AIALRA-0/Viterbi_Decoder/DECISIONS.md

# DECISIONS

# Decision D-001: Use K=7 [171,133] as default formal target

## Context
K=7 [171,133] is a classic convolutional-code configuration with 64 states, which is large enough to expose meaningful VLSI architecture pressure.

## Options
K=3 toy design, K=5 medium design, K=7 formal design.

## Decision
Use K=7 [171,133] as the formal target, and optionally use K=3 only for debug smoke tests.

## Reason
K=7 has enough complexity for the open-ended course project; K=3 is kept only as a teaching and debug smoke-test configuration.

## Consequence
RTL and traceback complexity increase, so automated verification must be stricter.

# Decision D-002: Keep local machine configuration out of git

## Context
`config/local.env` contains absolute local paths for Vivado, Vitis, the FIR reference repository, and private board documents.

## Options
Commit `config/local.env`, commit only a safe template, or leave configuration undocumented.

## Decision
Keep `config/local.env` ignored by git and commit only `config/env.example`.

## Reason
The project must be reproducible without exposing private local paths or board document locations.

## Consequence
Every machine must create its own `config/local.env` from `config/env.example` before running local or board tools.

# Decision D-003: Do not enable board execution or flash programming in M0

## Context
The master prompt requires JTAG and UART board validation later, but default policy forbids flash writes unless explicitly authorized.

## Options
Enable board execution immediately, keep board execution disabled until M7, or skip board planning.

## Decision
Set `ALLOW_BOARD_RUN=0` and `ALLOW_FLASH_WRITE=0` in `config/local.env`.

## Reason
M0 only verifies paths and tool setup. Real board execution belongs to M7 and flash programming is not authorized.

## Consequence
M7 must explicitly record any board run command and must still avoid flash writes.

# Decision D-004: Use full-sequence Python Viterbi as the M1 golden model

## Context
M1 needs a bit-true reference before RTL work starts. The traceback-depth approximation belongs to later hardware architecture exploration.

## Options
Use a full-sequence dynamic-programming decoder, immediately model finite traceback depth, or rely on handwritten expected vectors.

## Decision
Use a full-sequence dynamic-programming Viterbi decoder as the M1 golden model.

## Reason
It is deterministic, simple to verify for no-noise and small error cases, and provides a stable software reference before introducing hardware traceback constraints.

## Consequence
M5 must add explicit traceback-depth behavior and compare any finite-depth loss against this full-sequence reference.

# Decision D-005: Store vector hex files as one value per line

## Context
M2 vectors must feed Python, RTL simulation, and later board tests. A packed bitstream is compact but easy to misread across tools.

## Options
Pack bits into bytes, pack soft symbols into words, or store one value per line.

## Decision
Store every vector file as one value per line. Bit files contain `0` or `1`; soft3 files contain hexadecimal values `0` through `7`.

## Reason
The format is verbose but unambiguous, easy to inspect, and simple for testbenches to parse.

## Consequence
Later RTL and board scripts must preserve this file format or explicitly generate a derived packed format with separate metadata.

# Decision D-006: Use a spec-generated RTL package

## Context
The project rule says design parameters must come from `spec/viterbi_spec.json`, but RTL needs constants for K, state count, payload length, code length, and polynomials.

## Options
Hand-code constants in RTL, pass every constant as a simulator define, or generate a SystemVerilog package from spec.

## Decision
Generate `rtl/common/viterbi_pkg.sv` from `spec/viterbi_spec.json` with `scripts/gen_rtl_pkg.py`.

## Reason
This keeps Python, vectors, RTL, and testbench aligned to one source of truth.

## Consequence
Any spec change must regenerate `viterbi_pkg.sv` before RTL compile or synthesis.

# Decision D-007: Use a runtime case file instead of xsim plusargs

## Context
xsim rejected both absolute-path and relative-path plusarg values in the Windows `cmd` flow used here.

## Options
Keep debugging plusarg quoting, hard-code a single case, or let the regression script write a runtime case file.

## Decision
Use `tb/current_case.txt` as a generated runtime selector. The testbench reads the case id and opens `vectors/<case_id>`.

## Reason
It avoids tool-specific command-line parsing while preserving one compiled snapshot for all cases.

## Consequence
`tb/current_case.txt` is ignored by git and regenerated by `scripts/run_rtl_regression.py`.

# Decision D-008: Normalize soft3 path metrics after every trellis step

## Context
The soft3 branch metric can accumulate faster than the hard metric and later sweeps must compare finite path-metric widths.

## Options
Use unbounded simulation metrics, wrap on overflow, saturate only, or subtract the minimum metric after each trellis step.

## Decision
Use 12-bit hero metrics with subtract-min normalization after every trellis step.

## Reason
Subtract-min preserves relative path costs while keeping values small enough for fixed-width RTL.

## Consequence
Python golden and soft3 RTL both apply the same normalization policy for M4 hero verification.

# Decision D-009: Model traceback depth as finite delayed decisions in M5

## Context
M5 must sweep traceback depth. Treating traceback depth as a label without changing decoder behavior would hide the real latency/correction tradeoff.

## Options
Ignore traceback depth, rerun only full-frame traceback, or add finite delayed-decision traceback to the Python golden model.

## Decision
Add finite delayed-decision traceback to `model/viterbi_golden.py` and use it for M5 sweep rows.

## Reason
It produces real mismatch data for short traceback depths and keeps the sweep honest.

## Consequence
M5 data shows the actual effect of traceback depth; for the current vectors, `soft_awgn_0db` at depth 16 has mismatches while deeper settings recover the payload.

# Decision D-010: Treat M6 timing failure as a recorded result, not a blocker to report collection

## Context
Vivado implementation completed for the soft3 hero, but the 10 ns timing target was not met.

## Options
Hide the timing failure, keep rerunning implementation without architecture changes, or record the failure and critical path for the report.

## Decision
Record the timing failure and continue only because M6's required artifact is real synthesis/implementation data, not a guaranteed timing-clean design.

## Reason
The prompt explicitly says timing failures must not be hidden. The routed WNS/TNS and critical path are useful engineering results.

## Consequence
The final report must state that the current hero architecture is functionally verified but not timing-clean at 100 MHz, and must explain that the one-cycle 64-state soft ACS/reduction path needs pipelining.

# Decision D-011: Use OCM buffers for M7 board DMA validation

## Context
The first M7 board attempt used DDR buffer addresses and the decoder saw no AXI Stream input. The second attempt used OCM static buffers and the decoder saw 109 samples, but AXI DMA reported a decode error because the Vivado address map excluded `SEG_ps_0_HPC0_LPS_OCM`.

## Options
Keep debugging DDR access, move to a custom BRAM staging buffer, or match the FIR reference board shell by explicitly including the OCM segment for both DMA address spaces.

## Decision
Use OCM static buffers in the bare-metal app and include `SEG_ps_0_HPC0_LPS_OCM` for `/axi_dma_0/Data_MM2S` and `/axi_dma_0/Data_S2MM` in the Vivado block design.

## Reason
The FIR reference shell already used this pattern successfully on the same ZU4EV board. The Viterbi test buffers are small, so OCM capacity is sufficient and the DMA path is deterministic.

## Consequence
M7 board validation passed with 204 input samples and 96 output samples for all required cases. Larger future board vectors may need DDR access debug or a bigger staging strategy.

# Decision D-012: Label final report BER data as finite-vector observed mismatch rate

## Context
The final report prompt requires `data/analysis/ber_summary.csv`, but this project only ran the finite M2 vector set and the M5 parameter sweep. It did not run a large random-channel statistical BER campaign.

## Options
Invent a smooth BER curve, omit the required file, or generate the file from actual finite-vector mismatch counts and label the limitation clearly.

## Decision
Generate `data/analysis/ber_summary.csv` from real vector-level mismatch counts and describe it in the report as finite-vector observed mismatch rate, not as a statistically converged BER campaign.

## Reason
This satisfies the required data pipeline without fabricating experiment results.

## Consequence
The final report can compare hard and soft cases honestly, but it explicitly says the result is a functional verification summary rather than a channel-performance publication curve.
