AIALRA-0/Viterbi_Decoder/docs/assets/plots/fig14_depth_tradeoff.png

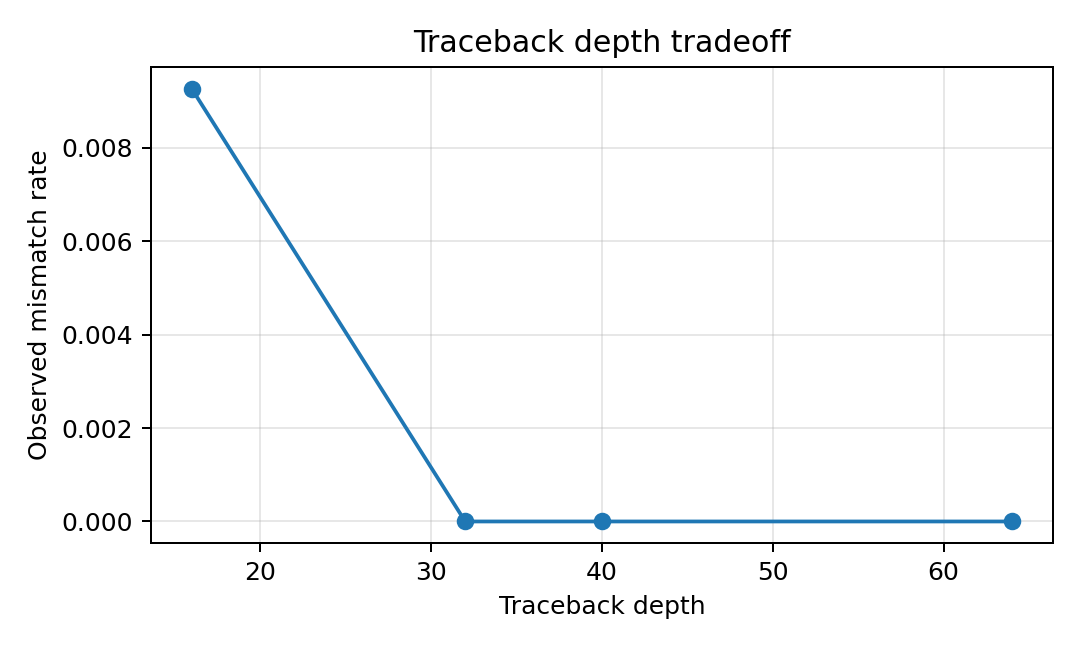
docs/assets/plots/fig14_depth_tradeoff.png
