AIALRA-0/Viterbi_Decoder/docs/assets/plots/fig15_width_resource_tradeoff.png

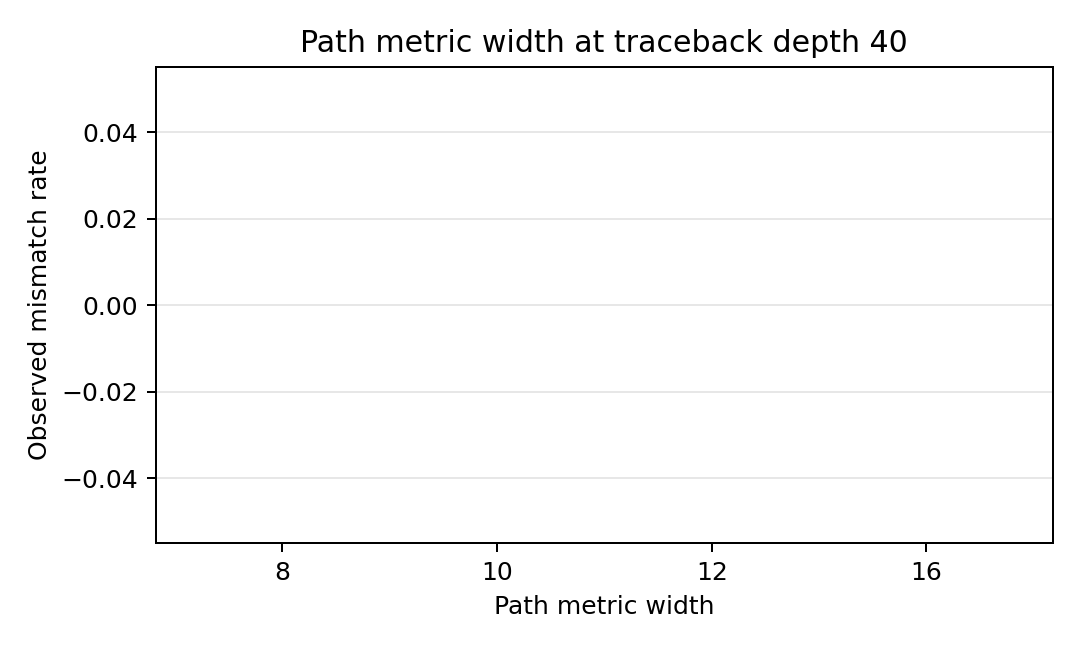
docs/assets/plots/fig15_width_resource_tradeoff.png
