AIALRA-0/Viterbi_Decoder/docs/assets/plots/fig16_fmax_resource_plot.png

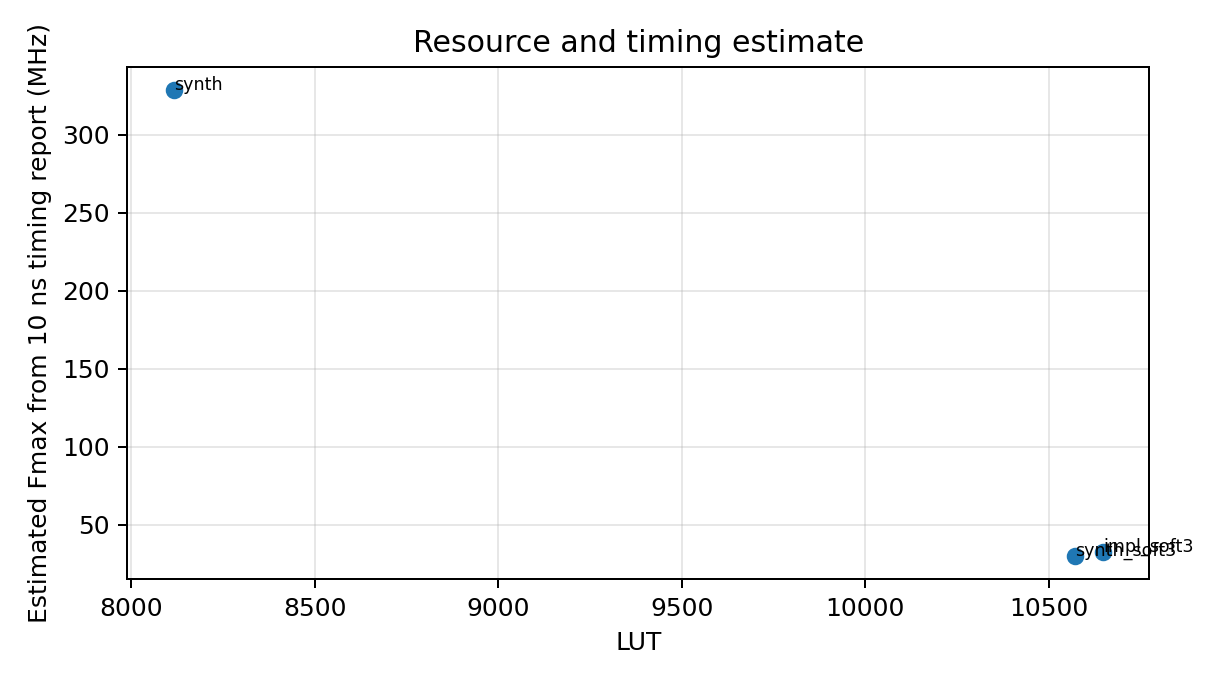
docs/assets/plots/fig16_fmax_resource_plot.png
