AIALRA-0/Viterbi_Decoder/docs/assets/plots/fig17_board_run_summary.png

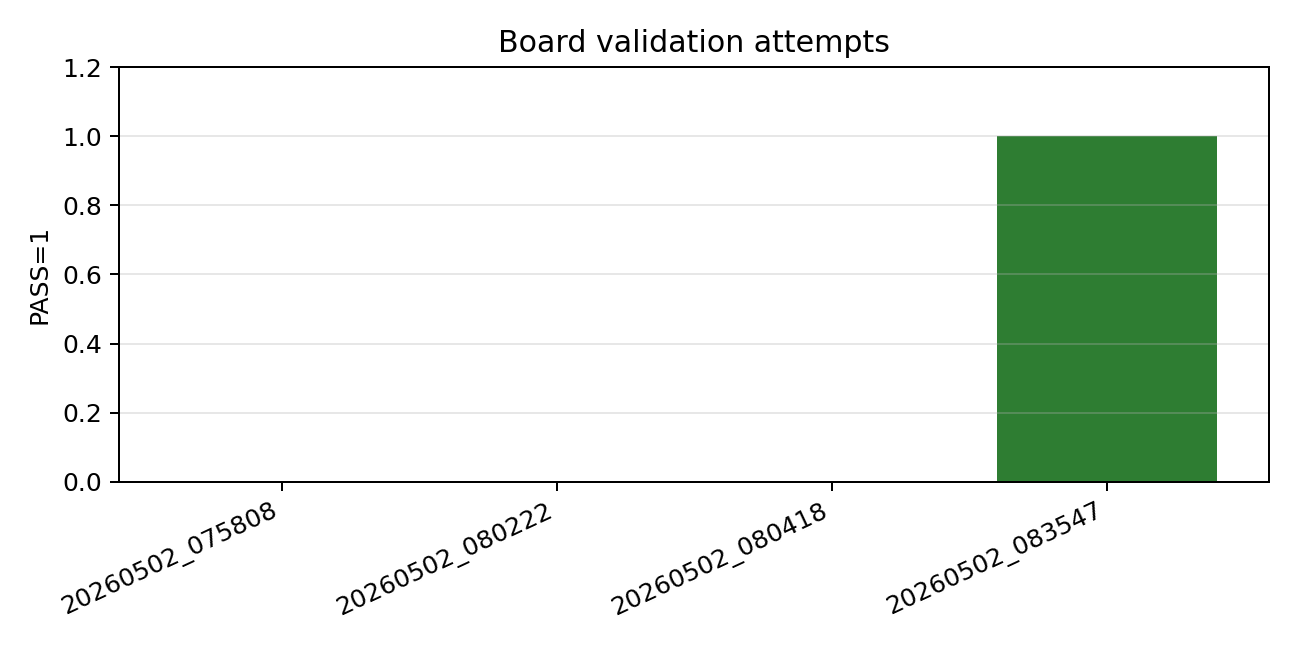
docs/assets/plots/fig17_board_run_summary.png
