AIALRA-0/Viterbi_Decoder/docs/assets/plots/m5_soft3_mismatch_vs_traceback.png

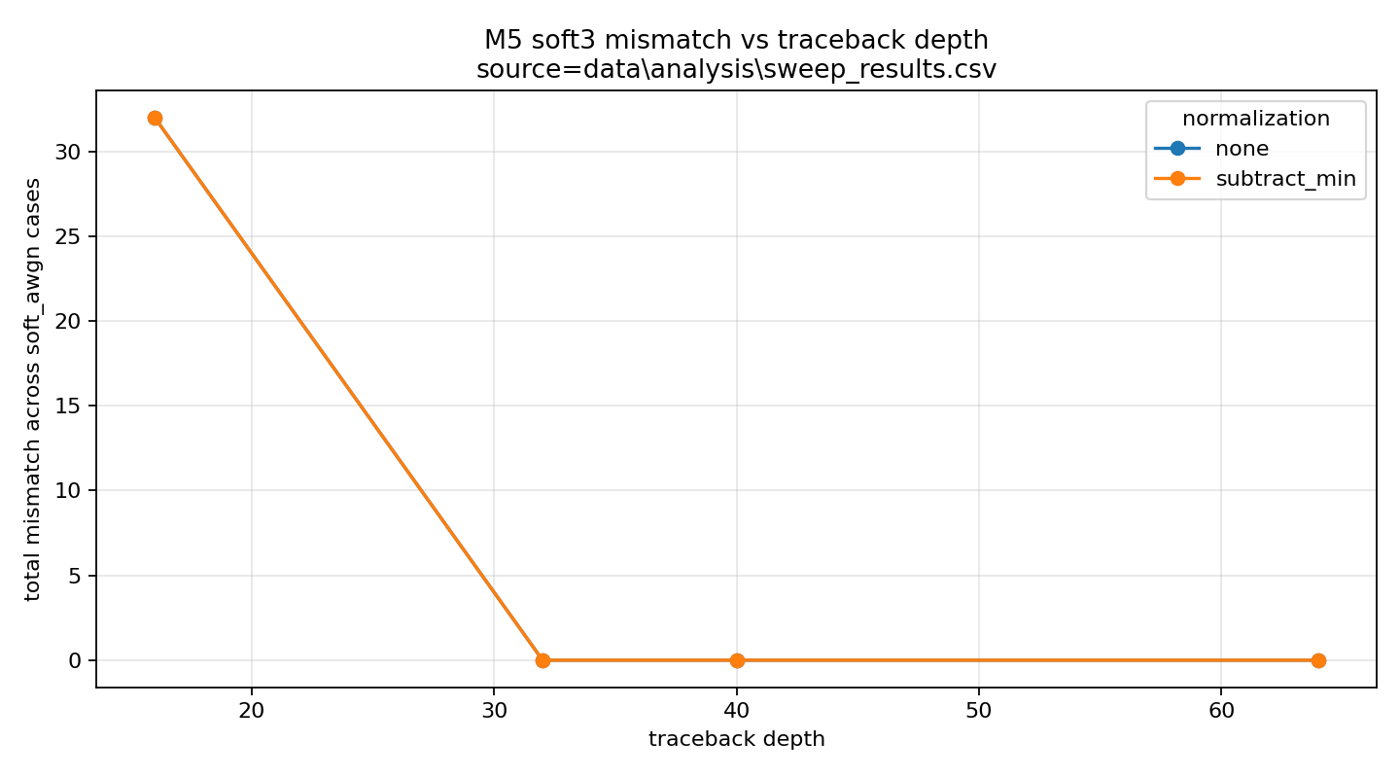
docs/assets/plots/m5_soft3_mismatch_vs_traceback.png
