AIALRA-0/Viterbi_Decoder/docs/assets/plots/m5_soft3_subtract_min_heatmap.png

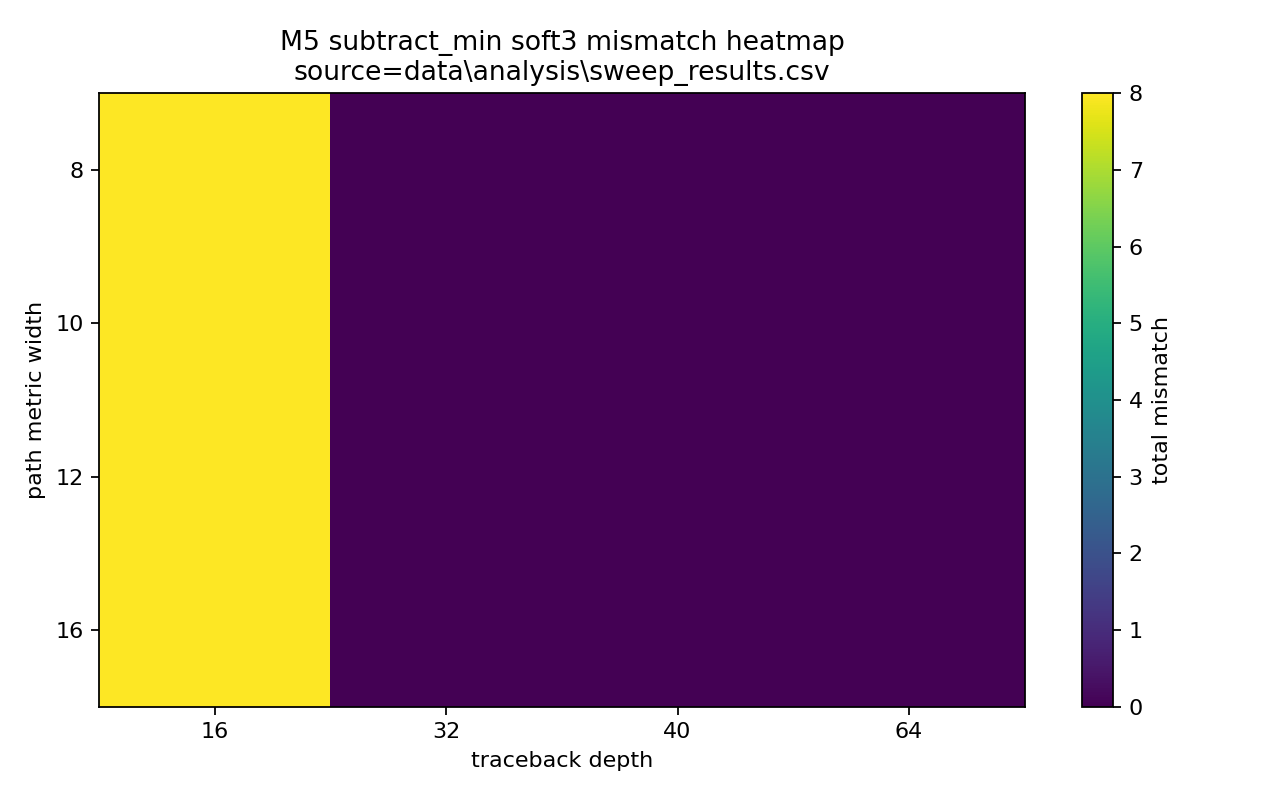
docs/assets/plots/m5_soft3_subtract_min_heatmap.png
