AIALRA-0/Viterbi_Decoder/EXPERIMENTS.yaml

# EXPERIMENTS.yaml

- id: m0_env_sanity_20260502_062312
  phase: M0
  mode: environment
  traceback_depth: null
  path_metric_width: null
  normalization: null
  vector_set: null
  command: "python scripts\\sanity_check_environment.py --env config\\local.env"
  result: PASS
  mismatch_count: null
  commit: pending
  notes: "pandas ABI warning and Vivado/xsct PATH warning observed; settings files exist and M0 passed."

- id: m1_model_pytest_20260502_062704
  phase: M1
  mode: python_golden
  traceback_depth: full_sequence
  path_metric_width: unbounded
  normalization: none
  vector_set: k3_smoke_and_k7_formal
  command: "python -m pytest tests -q"
  result: PASS
  tests_passed: 5
  tests_failed: 0
  mismatch_count: 0
  first_mismatch: null
  data: "data/model/model_unit_test_summary.json"
  commit: pending

- id: m2_vector_generation_20260502_063033
  phase: M2
  mode: vector_generation
  traceback_depth: full_sequence
  path_metric_width: unbounded
  normalization: none
  vector_set: "no_noise,all_zero,impulse_one,single_bit_error,burst_error_short,random_hard,soft_awgn_0db,soft_awgn_1db,soft_awgn_2db"
  command: "python scripts\\gen_vectors.py --spec spec\\viterbi_spec.json --out vectors"
  result: PASS
  tests_passed: 9
  tests_failed: 0
  mismatch_count: 0
  first_mismatch: null
  data: "vectors/summary.csv; data/model/vector_summary.csv"
  commit: pending
  notes: "Initial run failed because model package import path was missing; fixed by adding project root to sys.path."

- id: m3_rtl_hard_xsim_20260502_064131
  phase: M3
  mode: rtl_hard
  traceback_depth: full_sequence_frame
  path_metric_width: 10
  normalization: none
  vector_set: "no_noise,all_zero,impulse_one,single_bit_error"
  command: "python scripts\\run_rtl_regression.py --env config\\local.env --cases no_noise all_zero impulse_one single_bit_error"
  result: PASS
  tests_passed: 4
  tests_failed: 0
  mismatch_count: 0
  first_mismatch: null
  data: "data/regression/rtl_regression_summary.csv"
  commit: pending
  notes: "Intermediate tool/script failures were fixed before gate pass: settings quoting, reserved keyword, package timescale, xsim plusarg parsing."

- id: m4_soft3_xsim_20260502_064701
  phase: M4
  mode: rtl_soft3
  traceback_depth: full_sequence_frame
  path_metric_width: 12
  normalization: subtract_min
  vector_set: "soft_awgn_0db,soft_awgn_1db,soft_awgn_2db"
  command: "python scripts\\run_soft3_regression.py --env config\\local.env --cases soft_awgn_0db soft_awgn_1db soft_awgn_2db"
  result: PASS
  tests_passed: 3
  tests_failed: 0
  mismatch_count: 0
  first_mismatch: null
  data: "data/regression/soft3_regression_summary.csv"
  commit: pending
  notes: "Python pytest also passed 6 tests; hard RTL regression still passed 4 cases."

- id: m5_sweep_20260502_065045
  phase: M5
  mode: python_sweep
  traceback_depth: "16,32,40,64"
  path_metric_width: "8,10,12,16"
  normalization: "none,subtract_min"
  vector_set: "all M2 vectors"
  command: "python scripts\\run_sweeps.py --spec spec\\viterbi_spec.json --vectors vectors --out data\\analysis\\sweep_results.csv"
  result: PASS
  rows: 288
  mismatch_count: 64
  first_mismatch: 3
  data: "data/analysis/sweep_results.csv; docs/assets/plots/m5_soft3_mismatch_vs_traceback.png; docs/assets/plots/m5_soft3_subtract_min_heatmap.png"
  commit: pending
  notes: "All mismatches are from soft_awgn_0db at traceback depth 16."

- id: m6_vivado_20260502_070559
  phase: M6
  mode: vivado_ooc
  traceback_depth: full_sequence_frame
  path_metric_width: 12
  normalization: subtract_min
  vector_set: null
  command: "python scripts\\run_vivado_reports.py --env config\\local.env"
  result: PASS
  runs: 3
  tests_failed: 0
  baseline_synth_lut: 8116
  baseline_synth_ff: 15243
  hero_synth_lut: 10570
  hero_synth_ff: 17118
  hero_impl_lut: 10647
  hero_impl_ff: 17118
  hero_impl_wns_ns: -20.433
  hero_impl_tns_ns: -16272.939
  hero_impl_power_w: 0.487
  data: "data/impl/vivado_summary.csv; data/impl/timing_analysis.md"
  commit: pending
  notes: "Vivado implementation completed but timing was not met at 10 ns. Critical path recorded."

- id: m7_board_uart_20260502_083547
  phase: M7
  mode: zu4ev_board_uart
  traceback_depth: full_sequence_frame
  path_metric_width: 12
  normalization: subtract_min
  vector_set: "no_noise,single_bit_error,soft_awgn_2db"
  command: "python scripts\\run_board_validation.py --skip-build --build-info %VITERBI_STAGE%\\viterbi_zu4ev\\hero_soft3\\artifacts\\build_info.json --port COM9 --baud 115200 --capture-timeout 180"
  result: PASS
  cases: 3
  tests_passed: 3
  tests_failed: 0
  mismatch_count: 0
  first_mismatch: null
  cycles:
    no_noise: 802
    single_bit_error: 855
    soft_awgn_2db: 855
  input_samples_seen: 204
  output_samples_emitted: 96
  data: "data/board_runs/board_summary.csv; data/board_runs/m7_board_20260502_083547/uart.log; data/board_runs/m7_board_20260502_083547/uart_capture.json"
  commit: pending
  notes: "Earlier failed board attempts are retained. Final pass required including the OCM segment in the DMA address spaces."

- id: m8_final_report_20260502_084850
  phase: M8
  mode: final_report_generation
  traceback_depth: "source data from M5/M7"
  path_metric_width: "source data from M5/M6/M7"
  normalization: "source data from M5/M6/M7"
  vector_set: "all committed report source data"
  command: "python scripts\\build_final_report.py"
  result: PASS
  pdf_pages: 13
  pdf_text_chars: 15706
  tests_passed: 6
  tests_failed: 0
  artifact_scan: PASS
  data: "Report.md; Report.pdf; data/analysis/ber_summary.csv; data/analysis/traceback_depth_sweep.csv; data/analysis/path_metric_width_sweep.csv; docs/assets/plots/fig04_state_explosion.png; docs/assets/plots/fig05_hard_vs_soft_metric.png; docs/assets/plots/fig09_normalization_effect.png; docs/assets/plots/fig14_depth_tradeoff.png; docs/assets/plots/fig15_width_resource_tradeoff.png; docs/assets/plots/fig16_fmax_resource_plot.png; docs/assets/plots/fig17_board_run_summary.png"
  commit: pending
  notes: "BER summary is explicitly labeled as finite-vector observed mismatch rate; no fabricated channel curve."
