AIALRA-0/Viterbi_Decoder/(commit log)

2026-05-02 M2 generate Viterbi test vectors
    [summary.csv, vector_summary.csv]
2026-05-02 M3 add RTL hard-decision baseline
    [rtl_regression_summary.csv]
2026-05-02 M4 add soft-decision hero decoder
    [soft3_regression_summary.csv]
2026-05-02 M5 add traceback and metric sweeps
    [sweep_results.csv]
2026-05-02 M6 add Vivado implementation reports
    [vivado_summary.csv]
2026-05-02 M7 add ZU4EV board validation
    [board_summary.csv]
2026-05-02 M8 add final report and review
    [ber_summary.csv, path_metric_width_sweep.csv, traceback_depth_sweep.csv]
2026-05-04 Fix report flow diagrams
    [build_final_report.py]
2026-05-04 Finalize report and submission cleanup
    [board_summary.csv, rtl_regression_summary.csv, soft3_regression_summary.csv, vivado_summary.csv]
