AIALRA-0/Viterbi_Decoder/(notices)

Notices in the files:
README.md:
License: not specified
